iansan5653/knotmeter/cad/external_components/snap_eda/7282-2SG-30_connector-female.STEP

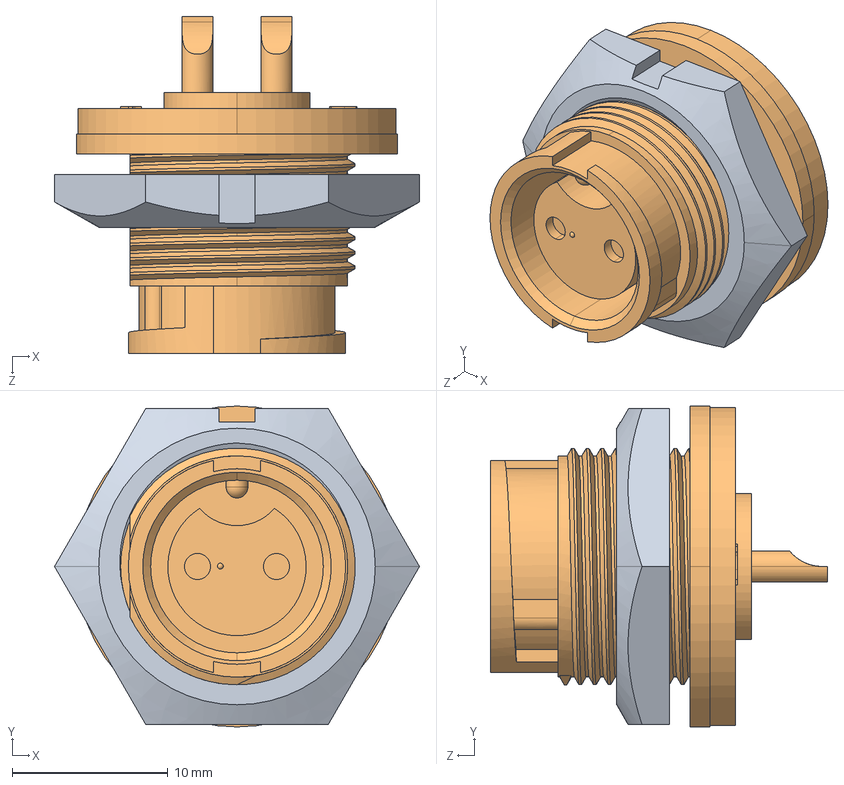
[picture p1: CAD file, 2022-07-16]
cad/external_components/snap_eda/7282-2SG-30_connector-female.STEP
23.5 x 20.6 x 21.6 mm
