iansan5653/knotmeter/(list of files, cad)

Other CAD files:
cad/led-display-assembly.SLDASM
cad/circuit-board.SLDASM
cad/knotmeter.SLDASM
cad/external_components/LM7805_voltage-regulator.SLDPRT
cad/external_components/protosupplies/PSA-1_led-display-controller.SLDPRT
cad/prints/faceplate.SLDPRT
cad/external_components/3-digit-led-display.SLDPRT
cad/prints/backplate.SLDPRT
cad/external_components/photoresistor.SLDPRT
cad/prints/temp-filler-plate.SLDPRT
cad/external_components/generic-header-pin.SLDPRT
cad/prints/labels.SLDPRT
cad/external_components/resistor.SLDPRT
cad/prints/body.SLDPRT
cad/external_components/GT-U7_gps.SLDPRT
cad/prints/cover.SLDPRT
cad/external_components/arduino-nano.SLDPRT
cad/external_components/female-header.SLDPRT
cad/external_components/5x7cm-protoboard.SLDPRT
cad/external_components/6103213AV0_gps-antenna.SLDPRT
cad/external_components/mcmaster_carr/1221T17_acrylic-disc.SLDPRT
