iansan5653/knotmeter/(commit log)

2022-05-16 Add acrylic lens and custom faceplate
    [1221T17_acrylic-disc.SLDPRT, faceplate.SLDPRT]
2022-05-20 Add LCD display module
    [PDC-6X1_lcd-display.SLDPRT]
2022-05-20 Add LCD details for clx & wiring
    [PDC-6X1_lcd-display.SLDPRT]
2022-05-20 Create body part with face
    [body.SLDPRT]
2022-05-22 Create assembly and make dimensions cross-dependent
    [body.SLDPRT, faceplate.SLDPRT, knotmeter.SLDASM]
2022-05-22 Add backplate piece
    [PDC-6X1_lcd-display.SLDPRT, backplate.SLDPRT, body.SLDPRT, faceplate.SLDPRT, knotmeter.SLDASM]
2022-05-26 Add alignment features
    [backplate.SLDPRT, faceplate.SLDPRT, knotmeter.SLDASM]
2022-06-07 Add mounting points for LCD
    [backplate.SLDPRT, faceplate.SLDPRT, knotmeter.SLDASM]
2022-06-08 Add cutout for LCDs
    [body.SLDPRT, knotmeter.SLDASM]
2022-06-08 Create models for GPS & antenna
    [6103213AV0_gps-antenna.SLDPRT, GT-U7_gps.SLDPRT]
2022-06-08 Add antenna cable to GPS module
    [GT-U7_gps.SLDPRT]
2022-06-08 Create Arduino Nano model
    [arduino-nano.SLDPRT]
2022-06-09 Remove one mounting post to clear space for circuit board
    [backplate.SLDPRT, faceplate.SLDPRT, knotmeter.SLDASM]
2022-06-09 Add protoboard model
    [5x7cm-protoboard.SLDPRT]
2022-06-09 Remove modeled-in header pins from GPS & nano
    [GT-U7_gps.SLDPRT, arduino-nano.SLDPRT]
2022-06-09 Add header pin model
    [generic-header-pin.SLDPRT]
2022-06-10 Add female header model
    [female-header.SLDPRT]
2022-06-10 Add circuit board model w/ nano and LCDs
    [PDC-6X1_lcd-display.SLDPRT, arduino-nano.SLDPRT]
2022-06-10 Add circuit board assembly
    [circuit-board.SLDASM, female-header.SLDPRT]
2022-06-10 Replace LCD part with circuit board assy
    [backplate.SLDPRT, body.SLDPRT, faceplate.SLDPRT, knotmeter.SLDASM]
2022-06-10 Move GPS to center to clear conflict
    [circuit-board.SLDASM]
2022-06-10 Finish mounting posts and fillets
    [PDC-6X1_lcd-display.SLDPRT, backplate.SLDPRT, body.SLDPRT, circuit-board.SLDASM, faceplate.SLDPRT, knotmeter.SLDASM]
2022-06-10 Rotate arduino for easier access
    [backplate.SLDPRT, circuit-board.SLDASM, faceplate.SLDPRT, knotmeter.SLDASM]
2022-06-10 Add GPS antenna to assembly
    [backplate.SLDPRT, faceplate.SLDPRT, knotmeter.SLDASM]
2022-06-11 Reduce acrylic gap & clip header pins
    [backplate.SLDPRT, body.SLDPRT, circuit-board.SLDASM, faceplate.SLDPRT, female-header.SLDPRT, generic-header-pin.SLDPRT, knotmeter.SLDASM, photoresistor.SLDPRT]
2022-06-11 Fix fillets in body
    [backplate.SLDPRT, circuit-board.SLDASM, faceplate.SLDPRT, knotmeter.SLDASM]
2022-06-11 Fix appearances / apply materials
    [backplate.SLDPRT, body.SLDPRT, faceplate.SLDPRT, knotmeter.SLDASM]
2022-06-11 Add pin label annotations
    [8056T12_through-panel-block.SLDPRT, 8076K12_circuit-board-mounted-terminal-block.SLDPRT, GT-U7_gps.SLDPRT, PDC-6X1_lcd-display.SLDPRT, arduino-nano.SLDPRT, circuit-board.SLDASM]
2022-06-12 Add circuit board traces
    [circuit-board.SLDASM, resistor.SLDPRT]
2022-06-12 Create 90-degree header pin variant
    [generic-header-pin.SLDPRT]
2022-06-12 Add photoresistor circuit
    [circuit-board.SLDASM]
2022-06-13 Add initial Arduino script w/ diagnostics
2022-06-28 Fix printing COG to wrong display and improve format
2022-06-28 Print the GPS fix status using battery indicator
2022-07-16 Add connector part file from SnapEDA
    [7282-2SG-30_connector-female.STEP]
2022-07-16 Add countersinks to screw holes
    [backplate.SLDPRT, body.SLDPRT, circuit-board.SLDASM, faceplate.SLDPRT, knotmeter.SLDASM]
2022-07-17 Add power connector hole & GPS antenna inset
    [8056T12_through-panel-block.SLDPRT, 8076K12_circuit-board-mounted-terminal-block.SLDPRT, backplate.SLDPRT, body.SLDPRT, faceplate.SLDPRT, knotmeter.SLDASM]
2022-07-17 Gitignore print files
2022-07-17 Adjust GPS antenna location
    [backplate.SLDPRT, body.SLDPRT, faceplate.SLDPRT, knotmeter.SLDASM]
2022-07-18 Add cover part
    [backplate.SLDPRT, body.SLDPRT, cover.SLDPRT, faceplate.SLDPRT, knotmeter.SLDASM]
2022-11-17 Adjust power connector angle to position between fasteners
    Fixes #2
    [backplate.SLDPRT, body.SLDPRT, faceplate.SLDPRT, knotmeter.SLDASM]
2022-12-06 Add LED display
    [3-digit-led-display.SLDPRT, knotmeter.SLDASM]
2022-12-06 Add LED display controller board
    [PSA-1_led-display-controller.SLDPRT]
2022-12-06 Add LED display assembly
    [3-digit-led-display.SLDPRT, PSA-1_led-display-controller.SLDPRT, led-display-assembly.SLDASM]
2023-02-26 Add temporary filler plate
    [temp-filler-plate.SLDPRT]
2023-02-26 Rework mates in circuit board to make replacing easier
    [backplate.SLDPRT, faceplate.SLDPRT]
2023-02-26 Replace LCD assemblies with LED assemblies
    [PDC-6X1_lcd-display.SLDPRT, backplate.SLDPRT, body.SLDPRT, circuit-board.SLDASM, faceplate.SLDPRT, knotmeter.SLDASM]
2023-02-26 Add labels & units
    [backplate.SLDPRT, body.SLDPRT, faceplate.SLDPRT, knotmeter.SLDASM]
2023-02-26 Reduce opening around displays
    [backplate.SLDPRT, body.SLDPRT, faceplate.SLDPRT, knotmeter.SLDASM]
2023-03-21 Update circuit board to work with LED boards
    [circuit-board.SLDASM]
2023-03-21 Increase label size for better print quality
    [backplate.SLDPRT, body.SLDPRT, faceplate.SLDPRT, knotmeter.SLDASM, labels.SLDPRT]
2023-03-21 Update Arduino config and rename file
2023-03-28 Update code to use `LedControl` to work with LED displays
2023-03-28 Improve messages and add fix animation
    [code.ino]
2023-03-28 Fix circuit board traces
    [backplate.SLDPRT, circuit-board.SLDASM]
2023-03-28 Add voltage regulator IC
    [LM7805_voltage-regulator.SLDPRT, circuit-board.SLDASM]
2023-03-28 Fix photoresistor trace
    [circuit-board.SLDASM]
2023-03-28 Improve trace layout and move resister across
    [PSA-1_led-display-controller.SLDPRT, circuit-board.SLDASM]
2023-03-30 Flip everything over since LED displays are backwards
    [code.ino]
2023-03-30 Switch COG and SOG displays in code
2023-03-30 Increase size of photores slot
    [backplate.SLDPRT, body.SLDPRT, circuit-board.SLDASM, faceplate.SLDPRT, knotmeter.SLDASM, labels.SLDPRT]
2023-03-30 Add retaining clips for GPS antenna
    [backplate.SLDPRT, body.SLDPRT, faceplate.SLDPRT, knotmeter.SLDASM, labels.SLDPRT, photoresistor.SLDPRT]
2023-03-30 Move connector to avoid GPS conflicts
    [backplate.SLDPRT, body.SLDPRT, faceplate.SLDPRT, knotmeter.SLDASM, labels.SLDPRT]
2023-03-30 Increase depth of antenna cutout
    [backplate.SLDPRT, body.SLDPRT, faceplate.SLDPRT, knotmeter.SLDASM, labels.SLDPRT]
